ShadrackAgyei/Model-NASA-mini-rover/Assets/schematics2.png

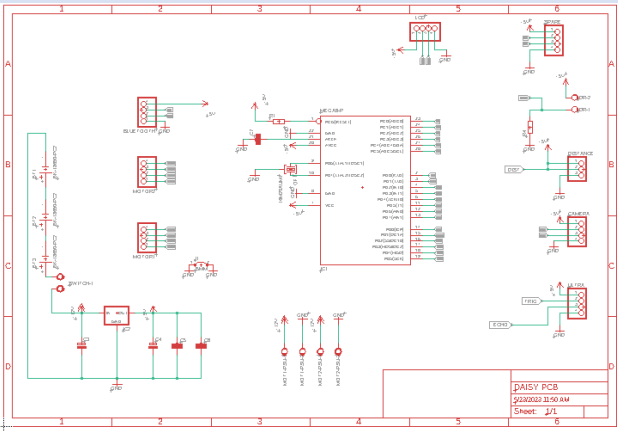
Assets/schematics2.png
