ShadrackAgyei/Model-NASA-mini-rover/Assets/Solidworks model.png

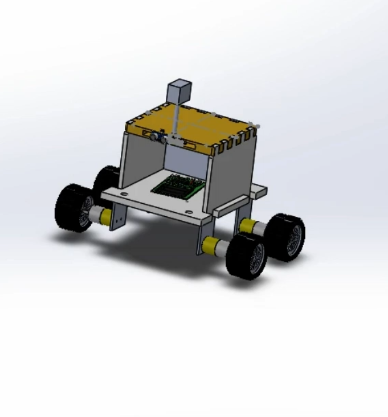
Assets/Solidworks model.png
